RobertBaruch/ninth_wave_256k/solder_side.jpg

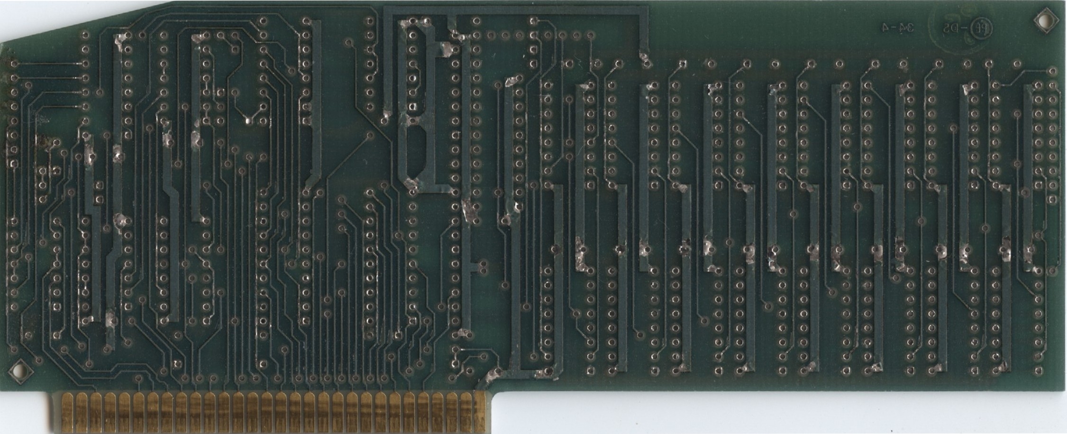
solder_side.jpg
