RobertBaruch/ninth_wave_256k/component_side.jpg

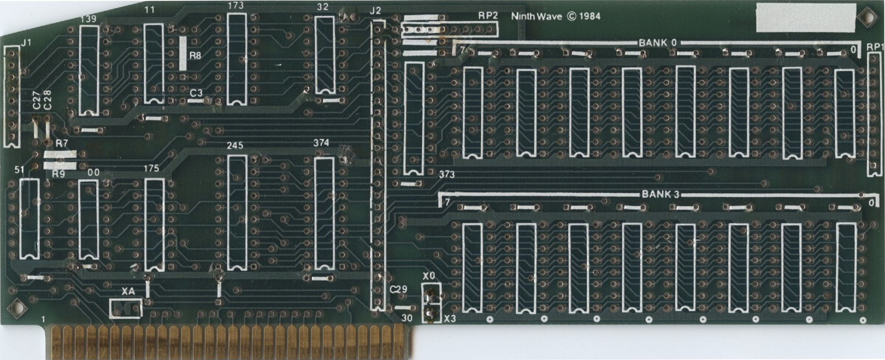
component_side.jpg
