RobertBaruch/ninth_wave_256k/README.md

Reverse engineered Ninth Wave memory expansion board for Apple IIe.

It's actually a 512k expansion.
