RobertBaruch/ninth_wave_256k/board.pdf

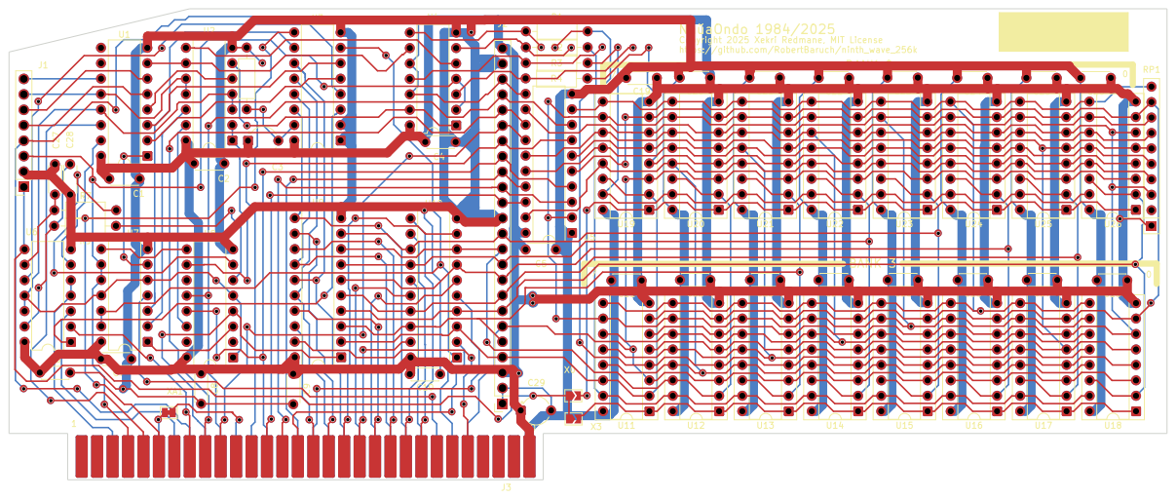
[picture p6: page 1]
