RobertBaruch/ninth_wave_256k/NinthWave512K.kicad_pcb

## KiCad design NinthWave512K.kicad_pcb (2025-06-15)

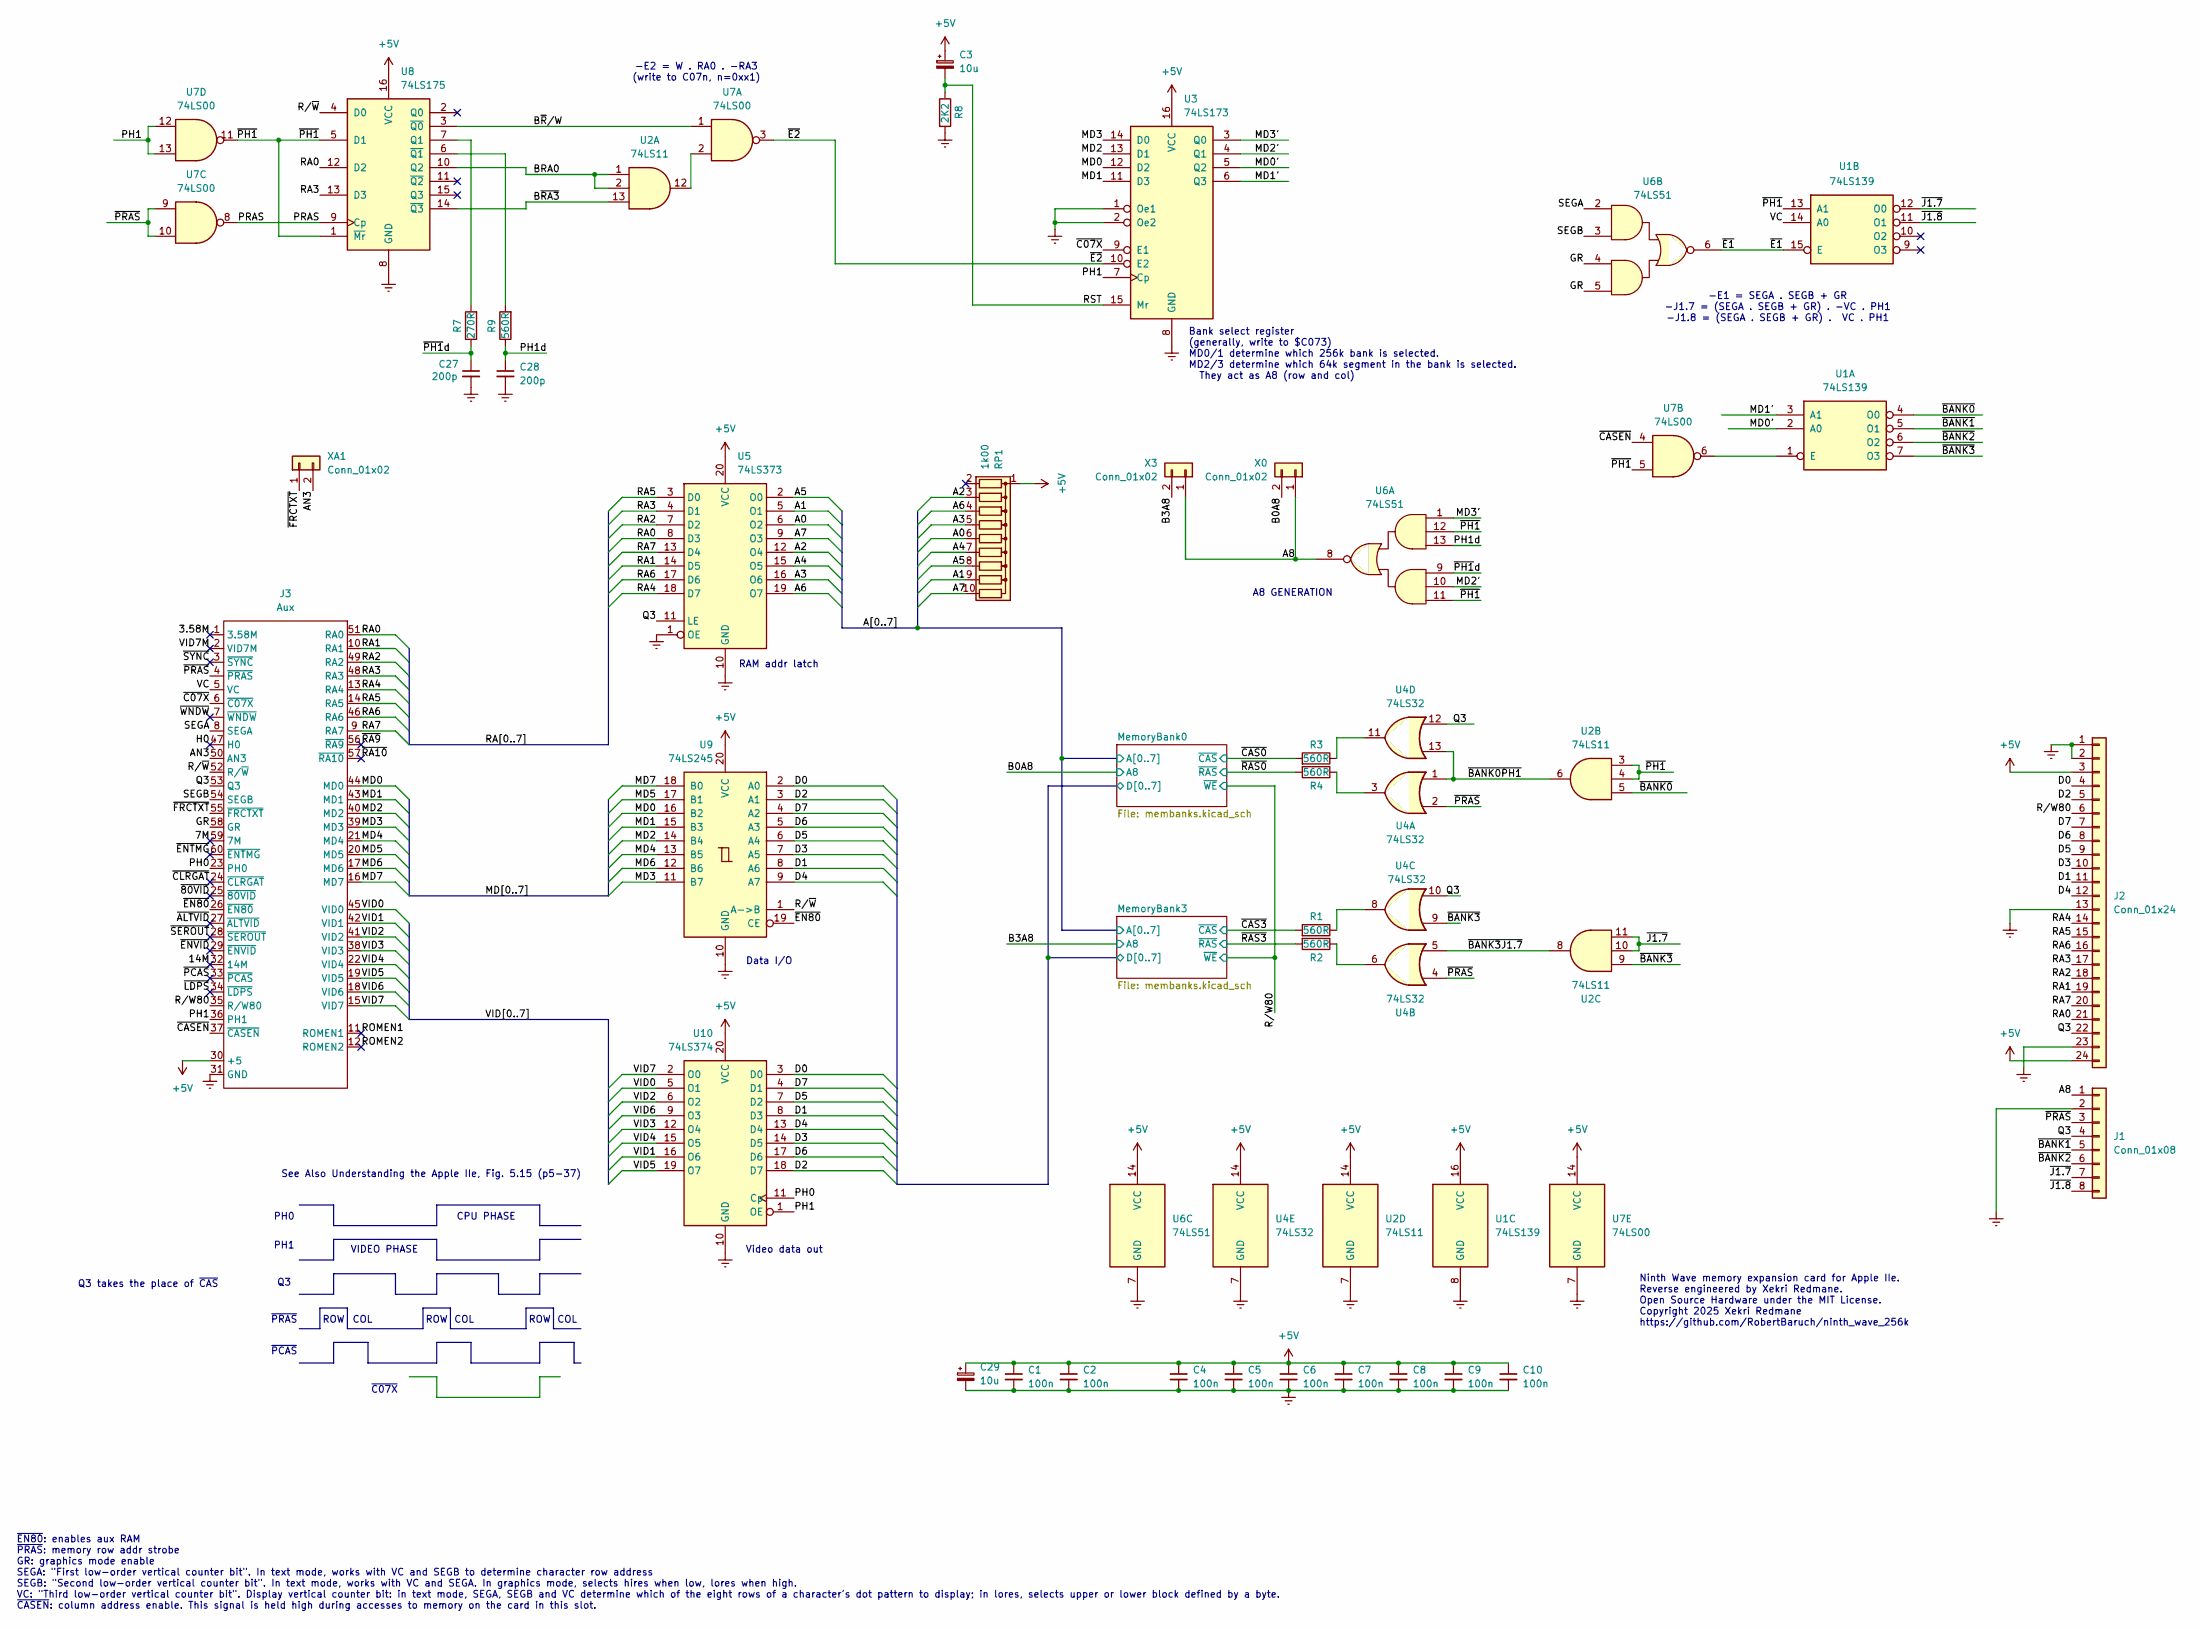
[picture p7: schematic NinthWave512K.kicad_sch]

Parts:
C1, C2, C4, C5, C6, C7, C8, C9, C10: 100n; C_Disc_D4.3mm_W1.9mm_P5.00mm
C3, C29: 10u; CP_Radial_Tantal_D4.5mm_P5.00mm
C27, C28: 200p; C_Disc_D4.3mm_W1.9mm_P5.00mm
J1: Conn_01x08; PinSocket_1x08_P2.54mm_Vertical
J2: Conn_01x24; PinSocket_1x24_P2.54mm_Vertical
J3: Aux; AuxPeriph
R1, R2, R3, R4, R9: 560R; R_Axial_DIN0207_L6.3mm_D2.5mm_P10.16mm_Horizontal
R7: 270R; R_Axial_DIN0207_L6.3mm_D2.5mm_P10.16mm_Horizontal
R8: 2K2; R_Axial_DIN0207_L6.3mm_D2.5mm_P10.16mm_Horizontal
RP1: 1k00; R_Array_SIP10
U1: 74LS139; DIP-16_W7.62mm
U2: 74LS11; DIP-14_W7.62mm
U3: 74LS173; DIP-16_W7.62mm
U4: 74LS32; DIP-14_W7.62mm
U5: 74LS373; DIP-20_W7.62mm
U6: 74LS51; DIP-14_W7.62mm
U7: 74LS00; DIP-14_W7.62mm
U8: 74LS175; DIP-16_W7.62mm
U9: 74LS245; DIP-20_W7.62mm
U10: 74LS374; DIP-20_W7.62mm
X0, X3: Conn_01x02; SolderJumper-2_P1.3mm_Open_TrianglePad1.0x1.5mm
XA1: Conn_01x02; SolderJumper-2_P1.3mm_Bridged_Pad1.0x1.5mm

Connections:
+5V: C1.1, C2.1, C3.1, C4.1, C5.1, C6.1, C7.1, C8.1, C9.1, C10.1, C29.1, J2.3, J2.24, J3.30 (+5), RP1.1 (common), U1.16 (VCC), U2.14 (VCC), U3.16 (VCC), U4.14 (VCC), U5.20 (VCC), U6.14 (VCC), U7.14 (VCC), U8.16 (VCC), U9.20 (VCC), U10.20 (VCC); also elsewhere on the board
/3.58M: J3.1 (3.58M)
/7M: J3.59 (7M)
/14M: J3.32 (14M)
/A0: RP1.6 (R5), U5.6 (O2); also elsewhere on the board
/A1: RP1.9 (R8), U5.5 (O1); also elsewhere on the board
/A2: RP1.3 (R2), U5.12 (O4); also elsewhere on the board
/A3: RP1.5 (R4), U5.16 (O6); also elsewhere on the board
/A4: RP1.7 (R6), U5.15 (O5); also elsewhere on the board
/A5: RP1.8 (R7), U5.2 (O0); also elsewhere on the board
/A6: RP1.4 (R3), U5.19 (O7); also elsewhere on the board
/A7: RP1.10 (R9), U5.9 (O3); also elsewhere on the board
/A8: J1.1, U6.8, X0.1, X3.1
/AN3: J3.50 (AN3), XA1.2
/B0A8: X0.2; also elsewhere on the board
/B3A8: X3.2; also elsewhere on the board
/BRA0: U2.1, U2.2, U8.10 (Q2)
/B~RA3: U2.13, U8.14 (~Q3)
/B~R/W: U7.1, U8.3 (~Q0)
/GR: J3.58 (GR), U6.4, U6.5
/H0: J3.47 (H0)
/J1.7: J1.7, U1.12 (O0), U2.10, U2.11
/J1.8: J1.8, U1.11 (O1)
/MD0: J3.44 (MD0), U3.12 (D2), U9.16 (B2)
/MD0': U1.2 (A0), U3.5 (Q2)
/MD1: J3.43 (MD1), U3.11 (D3), U9.15 (B3)
/MD1': U1.3 (A1), U3.6 (Q3)
/MD2: J3.40 (MD2), U3.13 (D1), U9.14 (B4)
/MD2': U3.4 (Q1), U6.10
/MD3: J3.39 (MD3), U3.14 (D0), U9.11 (B7)
/MD3': U3.3 (Q0), U6.1
/MD4: J3.21 (MD4), U9.13 (B5)
/MD5: J3.20 (MD5), U9.17 (B1)
/MD6: J3.17 (MD6), U9.12 (B6)
/MD7: J3.16 (MD7), U9.18 (B0)
/MemoryBank0/D0: J2.4, U9.2 (A0), U10.3 (D0); also elsewhere on the board
/MemoryBank0/D1: J2.11, U9.8 (A6), U10.8 (D3); also elsewhere on the board
/MemoryBank0/D2: J2.5, U9.3 (A1), U10.18 (D7); also elsewhere on the board
/MemoryBank0/D3: J2.10, U9.7 (A5), U10.14 (D5); also elsewhere on the board
/MemoryBank0/D4: J2.12, U9.9 (A7), U10.13 (D4); also elsewhere on the board
/MemoryBank0/D5: J2.9, U9.6 (A4), U10.7 (D2); also elsewhere on the board
/MemoryBank0/D6: J2.8, U9.5 (A3), U10.17 (D6); also elsewhere on the board
/MemoryBank0/D7: J2.7, U9.4 (A2), U10.4 (D1); also elsewhere on the board
/PH0: J3.23 (PH0), U10.11 (Cp)
/PH1: J3.36 (PH1), U3.7 (Cp), U7.12, U7.13, U10.1 (OE)
/PH1d: C28.1, R9.1, U6.13
/PRAS: U7.8, U8.9 (Cp)
/Q3: J1.4, J2.22, J3.53 (Q3), U4.10, U4.12, U5.11 (LE)
/RA0: J2.21, J3.51 (RA0), U5.8 (D3), U8.12 (D2)
/RA1: J2.19, J3.10 (RA1), U5.14 (D5)
/RA2: J2.18, J3.49 (RA2), U5.7 (D2)
/RA3: J2.17, J3.48 (RA3), U5.4 (D1), U8.13 (D3)
/RA4: J2.14, J3.13 (RA4), U5.18 (D7)
/RA5: J2.15, J3.14 (RA5), U5.3 (D0)
/RA6: J2.16, J3.46 (RA6), U5.17 (D6)
/RA7: J2.20, J3.9 (RA7), U5.13 (D4)
/ROMEN1: J3.11 (ROMEN1)
/ROMEN2: J3.12 (ROMEN2)
/RST: C3.2, R8.1, U3.15 (Mr)
/R/W80: J2.6, J3.35 (R/W80); also elsewhere on the board
/R/~W: J3.52 (R/~W), U8.4 (D0), U9.1 (A->B)
/SEGA: J3.8 (SEGA), U6.2
/SEGB: J3.54 (SEGB), U6.3
/VC: J3.5 (VC), U1.14 (A0)
/VID0: J3.45 (VID0), U10.5 (O1)
/VID1: J3.42 (VID1), U10.16 (O6)
/VID2: J3.41 (VID2), U10.6 (O2)
/VID3: J3.38 (VID3), U10.12 (O4)
/VID4: J3.22 (VID4), U10.15 (O5)
/VID5: J3.19 (VID5), U10.19 (O7)
/VID6: J3.18 (VID6), U10.9 (O3)
/VID7: J3.15 (VID7), U10.2 (O0)
/VID7M: J3.2 (VID7M)
/~80VID: J3.25 (~80VID)
/~ALTVID: J3.27 (~ALTVID)
/~BANK0PH1: U2.6, U4.1, U4.13
/~BANK0: U1.4 (O0), U2.5
/~BANK1: J1.5, U1.5 (O1)
/~BANK2: J1.6, U1.6 (O2)
/~BANK3: U1.7 (O3), U2.9, U4.9
/~C07X: J3.6 (~C07X), U3.9 (E1)
/~CAS0: R3.2; also elsewhere on the board
/~CAS3: R1.2; also elsewhere on the board
/~CASEN: J3.37 (~CASEN), U7.4
/~CLRGAT: J3.24 (~CLRGAT)
/~E1: U1.15 (E), U6.6
/~E2: U3.10 (E2), U7.3
/~EN80: J3.26 (~EN80), U9.19 (CE)
/~ENTMG: J3.60 (~ENTMG)
/~ENVID: J3.29 (~ENVID)
/~FRCTXT: J3.55 (~FRCTXT), XA1.1
/~LDPS: J3.34 (~LDPS)
/~PCAS: J3.33 (~PCAS)
/~PH1: U1.13 (A1), U2.3, U2.4, U6.11, U6.12, U7.5, U7.11, U8.1 (~Mr), U8.5 (D1)
/~PH1d: C27.1, R7.1, U6.9
/~PRAS: J1.3, J3.4 (~PRAS), U4.2, U4.4, U7.9, U7.10
/~RA9: J3.56 (~RA9)
/~RA10: J3.57 (~RA10)
/~RAS0: R4.2; also elsewhere on the board
/~RAS3: R2.2; also elsewhere on the board
/~SEROUT: J3.28 (~SEROUT)
/~SYNC: J3.3 (~SYNC)
/~WNDW: J3.7 (~WNDW)
GNDREF: C1.2, C2.2, C4.2, C5.2, C6.2, C7.2, C8.2, C9.2, C10.2, C27.2, C28.2, C29.2, J1.2, J2.1, J2.2, J2.13, J2.23, J3.31 (GND), R8.2, U1.8 (GND), U2.7 (GND), U3.1 (Oe1), U3.2 (Oe2), U3.8 (GND), U4.7 (GND), U5.1 (OE), U5.10 (GND), U6.7 (GND), U7.7 (GND), U8.8 (GND), U9.10 (GND), U10.10 (GND); also elsewhere on the board
unnamed: R1.1, U4.8
unnamed: R2.1, U4.6
unnamed: R3.1, U4.11
unnamed: R4.1, U4.3
unnamed: U1.1 (E), U7.6
unnamed: U2.8, U4.5
unnamed: U2.12, U7.2
unnamed: R7.2, U8.7 (Q1)
unnamed: R9.2, U8.6 (~Q1)

Notes on the sheet:
COL
-E1 = SEGA . SEGB + GR -J1.7 = (SEGA . SEGB + GR) . -VC . PH1 -J1.8 = (SEGA . SEGB + GR) . VC . PH1
A8 GENERATION
PH0
PH1
ROW
VIDEO PHASE
RAM addr latch
Ninth Wave memory expansion card for Apple IIe. Reverse engineered by Xekri Redmane. Open Source Hardware under the MIT License. Copyright 2025 Xekri Redmane https://github.com/RobertBaruch/ninth_wave_256k
~{PCAS}
Bank select register (generally, write to $C073) MD0/1 determine which 256k bank is selected. MD2/3 determine which 64k segment in the bank is selected. They act as A8 (row and col)
-E2 = W . RA0 . -RA3 (write to C07n, n=0xx1)
Data I/O
CPU PHASE
~{C07X}
~{PRAS}
Q3 takes the place of ~{CAS}
~{EN80}: enables aux RAM ~{PRAS}: memory row addr strobe GR: graphics mode enable SEGA: "First low-order vertical counter bit". In text mode, works with VC and SEGB to determine character row address SEGB: "Second low-order vertical counter bit". In text mode, works with VC and SEGA. In graphics mo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
Video data out
See Also Understanding the Apple IIe, Fig. 5.15 (p5-37)

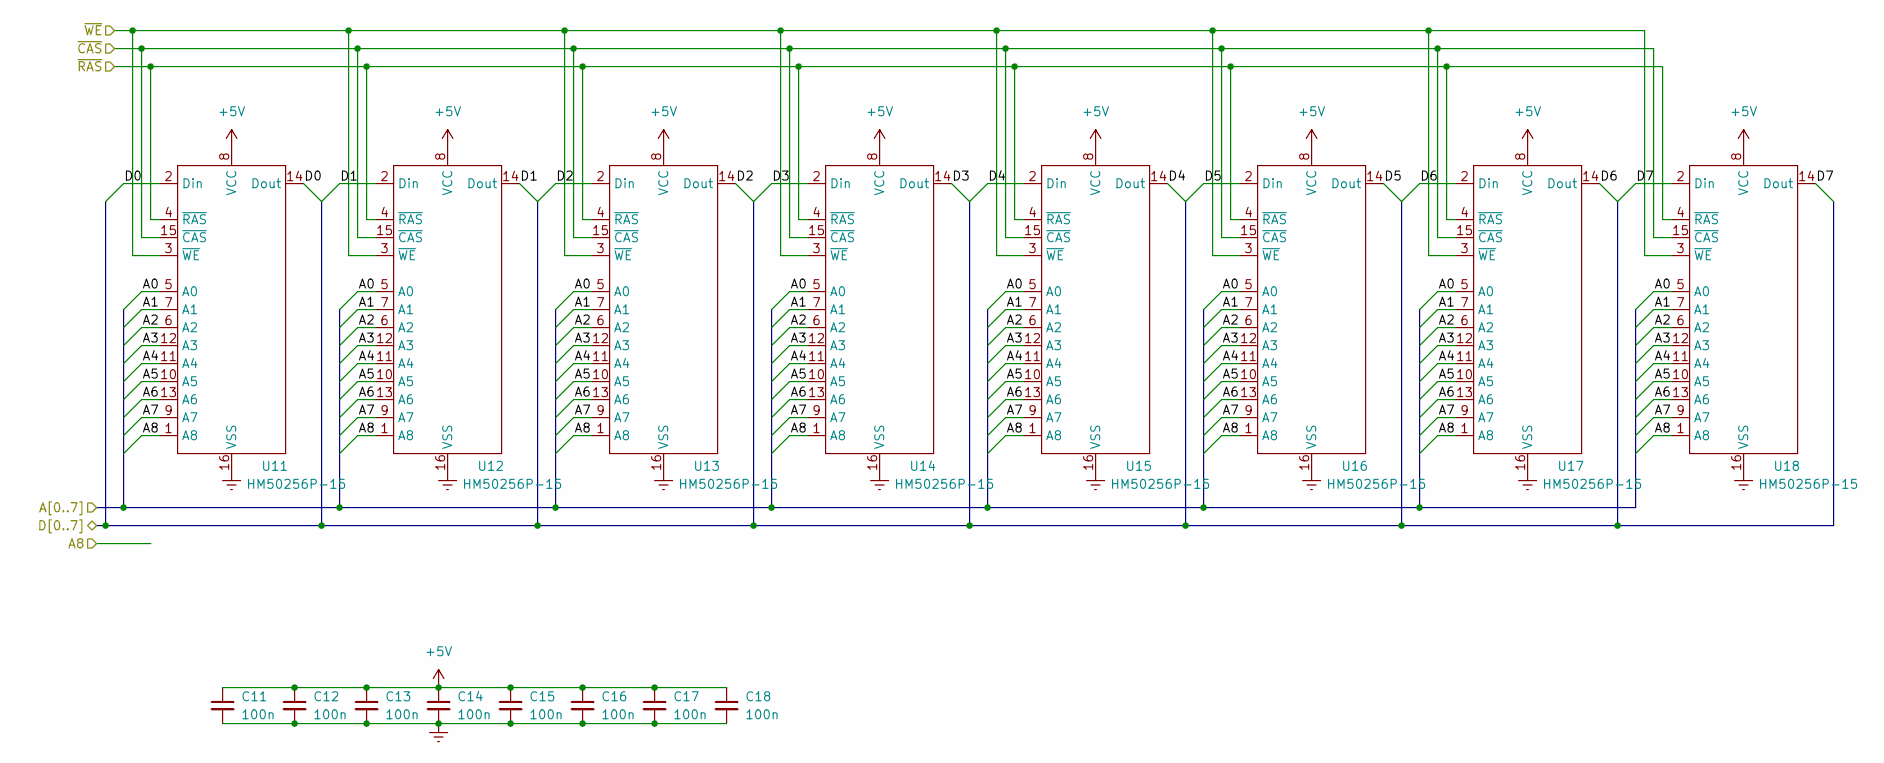
[picture p8: schematic membanks.kicad_sch]

Parts:
C11, C12, C13, C14, C15, C16, C17, C18: 100n; C_Disc_D4.3mm_W1.9mm_P5.00mm
U11, U12, U13, U14, U15, U16, U17, U18: HM50256P-15; DIP-16_W7.62mm_Socket

Connections:
+5V: C11.1, C12.1, C13.1, C14.1, C15.1, C16.1, C17.1, C18.1, U11.8 (VCC), U12.8 (VCC), U13.8 (VCC), U14.8 (VCC), U15.8 (VCC), U16.8 (VCC), U17.8 (VCC), U18.8 (VCC); also elsewhere on the board
/A0: U11.5 (A0), U12.5 (A0), U13.5 (A0), U14.5 (A0), U15.5 (A0), U16.5 (A0), U17.5 (A0), U18.5 (A0); also elsewhere on the board
/A1: U11.7 (A1), U12.7 (A1), U13.7 (A1), U14.7 (A1), U15.7 (A1), U16.7 (A1), U17.7 (A1), U18.7 (A1); also elsewhere on the board
/A2: U11.6 (A2), U12.6 (A2), U13.6 (A2), U14.6 (A2), U15.6 (A2), U16.6 (A2), U17.6 (A2), U18.6 (A2); also elsewhere on the board
/A3: U11.12 (A3), U12.12 (A3), U13.12 (A3), U14.12 (A3), U15.12 (A3), U16.12 (A3), U17.12 (A3), U18.12 (A3); also elsewhere on the board
/A4: U11.11 (A4), U12.11 (A4), U13.11 (A4), U14.11 (A4), U15.11 (A4), U16.11 (A4), U17.11 (A4), U18.11 (A4); also elsewhere on the board
/A5: U11.10 (A5), U12.10 (A5), U13.10 (A5), U14.10 (A5), U15.10 (A5), U16.10 (A5), U17.10 (A5), U18.10 (A5); also elsewhere on the board
/A6: U11.13 (A6), U12.13 (A6), U13.13 (A6), U14.13 (A6), U15.13 (A6), U16.13 (A6), U17.13 (A6), U18.13 (A6); also elsewhere on the board
/A7: U11.9 (A7), U12.9 (A7), U13.9 (A7), U14.9 (A7), U15.9 (A7), U16.9 (A7), U17.9 (A7), U18.9 (A7); also elsewhere on the board
/B3A8: U11.1 (A8), U12.1 (A8), U13.1 (A8), U14.1 (A8), U15.1 (A8), U16.1 (A8), U17.1 (A8), U18.1 (A8); also elsewhere on the board
/MemoryBank0/D0: U11.2 (Din), U11.14 (Dout); also elsewhere on the board
/MemoryBank0/D1: U12.2 (Din), U12.14 (Dout); also elsewhere on the board
/MemoryBank0/D2: U13.2 (Din), U13.14 (Dout); also elsewhere on the board
/MemoryBank0/D3: U14.2 (Din), U14.14 (Dout); also elsewhere on the board
/MemoryBank0/D4: U15.2 (Din), U15.14 (Dout); also elsewhere on the board
/MemoryBank0/D5: U16.2 (Din), U16.14 (Dout); also elsewhere on the board
/MemoryBank0/D6: U17.2 (Din), U17.14 (Dout); also elsewhere on the board
/MemoryBank0/D7: U18.2 (Din), U18.14 (Dout); also elsewhere on the board
/R/W80: U11.3 (~WE), U12.3 (~WE), U13.3 (~WE), U14.3 (~WE), U15.3 (~WE), U16.3 (~WE), U17.3 (~WE), U18.3 (~WE); also elsewhere on the board
/~CAS3: U11.15 (~CAS), U12.15 (~CAS), U13.15 (~CAS), U14.15 (~CAS), U15.15 (~CAS), U16.15 (~CAS), U17.15 (~CAS), U18.15 (~CAS); also elsewhere on the board
/~RAS3: U11.4 (~RAS), U12.4 (~RAS), U13.4 (~RAS), U14.4 (~RAS), U15.4 (~RAS), U16.4 (~RAS), U17.4 (~RAS), U18.4 (~RAS); also elsewhere on the board
GNDREF: C11.2, C12.2, C13.2, C14.2, C15.2, C16.2, C17.2, C18.2, U11.16 (VSS), U12.16 (VSS), U13.16 (VSS), U14.16 (VSS), U15.16 (VSS), U16.16 (VSS), U17.16 (VSS), U18.16 (VSS); also elsewhere on the board

Parts of its further copies:
C19, C20, C21, C22, C23, C24, C25, C26: 100n; C_Disc_D4.3mm_W1.9mm_P5.00mm
U19, U20, U21, U22, U23, U24, U25, U26: HM50256P-15; DIP-16_W7.62mm_Socket

Connections of its further copies:
+5V: C19.1, C20.1, C21.1, C22.1, C23.1, C24.1, C25.1, C26.1, U19.8 (VCC), U20.8 (VCC), U21.8 (VCC), U22.8 (VCC), U23.8 (VCC), U24.8 (VCC), U25.8 (VCC), U26.8 (VCC); also elsewhere on the board
/A0: U19.5 (A0), U20.5 (A0), U21.5 (A0), U22.5 (A0), U23.5 (A0), U24.5 (A0), U25.5 (A0), U26.5 (A0); also elsewhere on the board
/A1: U19.7 (A1), U20.7 (A1), U21.7 (A1), U22.7 (A1), U23.7 (A1), U24.7 (A1), U25.7 (A1), U26.7 (A1); also elsewhere on the board
/A2: U19.6 (A2), U20.6 (A2), U21.6 (A2), U22.6 (A2), U23.6 (A2), U24.6 (A2), U25.6 (A2), U26.6 (A2); also elsewhere on the board
/A3: U19.12 (A3), U20.12 (A3), U21.12 (A3), U22.12 (A3), U23.12 (A3), U24.12 (A3), U25.12 (A3), U26.12 (A3); also elsewhere on the board
/A4: U19.11 (A4), U20.11 (A4), U21.11 (A4), U22.11 (A4), U23.11 (A4), U24.11 (A4), U25.11 (A4), U26.11 (A4); also elsewhere on the board
/A5: U19.10 (A5), U20.10 (A5), U21.10 (A5), U22.10 (A5), U23.10 (A5), U24.10 (A5), U25.10 (A5), U26.10 (A5); also elsewhere on the board
/A6: U19.13 (A6), U20.13 (A6), U21.13 (A6), U22.13 (A6), U23.13 (A6), U24.13 (A6), U25.13 (A6), U26.13 (A6); also elsewhere on the board
/A7: U19.9 (A7), U20.9 (A7), U21.9 (A7), U22.9 (A7), U23.9 (A7), U24.9 (A7), U25.9 (A7), U26.9 (A7); also elsewhere on the board
/B0A8: U19.1 (A8), U20.1 (A8), U21.1 (A8), U22.1 (A8), U23.1 (A8), U24.1 (A8), U25.1 (A8), U26.1 (A8); also elsewhere on the board
/MemoryBank0/D0: U19.2 (Din), U19.14 (Dout); also elsewhere on the board
/MemoryBank0/D1: U20.2 (Din), U20.14 (Dout); also elsewhere on the board
/MemoryBank0/D2: U21.2 (Din), U21.14 (Dout); also elsewhere on the board
/MemoryBank0/D3: U22.2 (Din), U22.14 (Dout); also elsewhere on the board
/MemoryBank0/D4: U23.2 (Din), U23.14 (Dout); also elsewhere on the board
/MemoryBank0/D5: U24.2 (Din), U24.14 (Dout); also elsewhere on the board
/MemoryBank0/D6: U25.2 (Din), U25.14 (Dout); also elsewhere on the board
/MemoryBank0/D7: U26.2 (Din), U26.14 (Dout); also elsewhere on the board
/R/W80: U19.3 (~WE), U20.3 (~WE), U21.3 (~WE), U22.3 (~WE), U23.3 (~WE), U24.3 (~WE), U25.3 (~WE), U26.3 (~WE); also elsewhere on the board
/~CAS0: U19.15 (~CAS), U20.15 (~CAS), U21.15 (~CAS), U22.15 (~CAS), U23.15 (~CAS), U24.15 (~CAS), U25.15 (~CAS), U26.15 (~CAS); also elsewhere on the board
/~RAS0: U19.4 (~RAS), U20.4 (~RAS), U21.4 (~RAS), U22.4 (~RAS), U23.4 (~RAS), U24.4 (~RAS), U25.4 (~RAS), U26.4 (~RAS); also elsewhere on the board
GNDREF: C19.2, C20.2, C21.2, C22.2, C23.2, C24.2, C25.2, C26.2, U19.16 (VSS), U20.16 (VSS), U21.16 (VSS), U22.16 (VSS), U23.16 (VSS), U24.16 (VSS), U25.16 (VSS), U26.16 (VSS); also elsewhere on the board

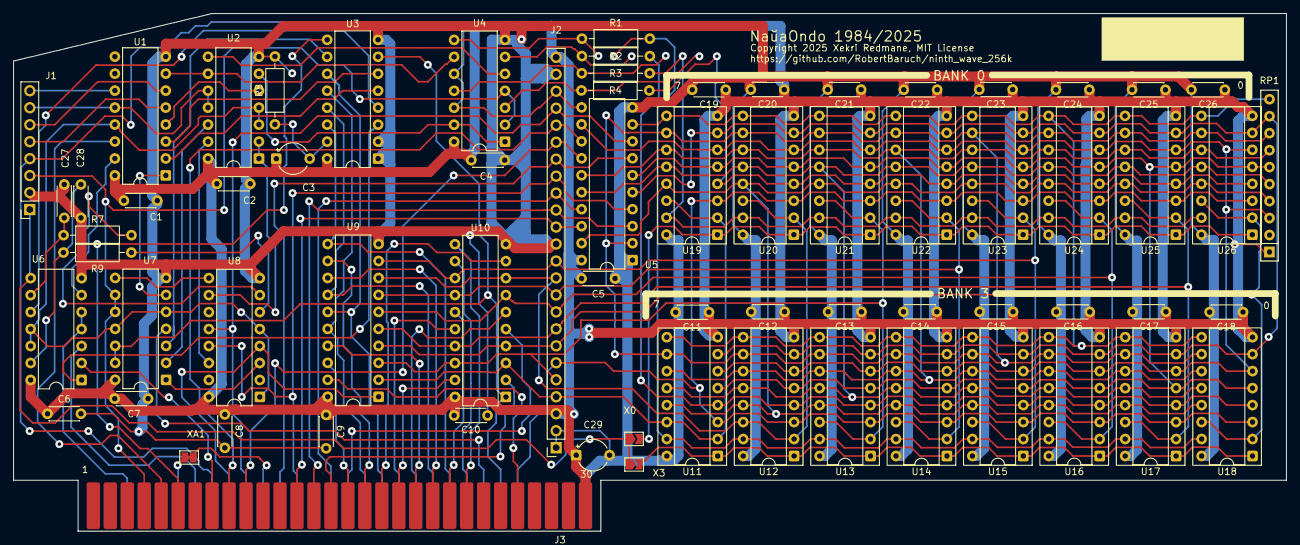
[picture p9: board NinthWave512K.kicad_pcb from above]

Board: 2 copper layers, 190.5 x 77.5 mm, 69 parts (0 on the bottom side), 94 nets.
