RobertBaruch/ninth_wave_256k/(notices)

Notices in the files:
NinthWave512K.kicad_pcb:
Copyright 2025 Xekri Redmane, MIT License
